siddij3/Inkjet-Printer/README.md

# Inkjet-Printer

DIY Inkjet Printer using Rep-Rap 3D Printing inspired parts and components
