siddij3/Inkjet-Printer/HP45 Printhed PCB/PCB-BOM.xlsx

Quantity | Value | Part Name | Model | Digikey Part #
4 | 0.1µF | Capacitor | C0603 | 399-6304-6-ND (https://www.digikey.ca/product-detail/en/kemet/C0603T104K5RALTU/399-6304-6-ND/2793681)
1 | 0.33µF | Capacitor | C0603 | 399-4916-6-ND (https://www.digikey.ca/product-detail/en/kemet/C0603C334K4RACTU/399-4916-6-ND/1305499)
9 |  | Spring Loaded Pin | 903 | ED90344-ND
1 |  | Voltage Regulator | L78M05CDT | 511-L78M05CDT-TR | Mouser Canada
1 |  | 5-pin Through Hole Connector | 640454-5 | A19432-ND
1 |  | Terminal Block | 282837-2 | 113320-ND
1 |  | PIC Microcontroller | PIC18F25K50T-I/ML | PIC18F25K50T-I/MLTR-ND
1 | 100 Ω | Resistor | R0805 | CR0805-FX-1000ELFCT-ND (https://www.digikey.ca/product-detail/en/bourns-inc/CR0805-FX-1000ELF/CR0805-FX-1000ELFCT-ND/3740922)
1 | 10 KΩ | Resistor | R0805 | CR0805-FX-1002ELFTR-ND (https://www.digikey.ca/product-detail/en/bourns-inc/CR0805-FX-1002ELF/CR0805-FX-1002ELFTR-ND/3593209)
8 | 5 KΩ | Resistor | R0603 | CR0603-FX-5101ELFCT-ND (https://www.digikey.ca/product-detail/en/bourns-inc/CR0603-FX-5101ELF/CR0603-FX-5101ELFCT-ND/3925320)
2 | 1KΩ | Resistor | R0603 | CR0603-FX-1001ELFCT-ND (https://www.digikey.ca/product-detail/en/bourns-inc/CR0603-FX-1001ELF/CR0603-FX-1001ELFCT-ND/3592910)
2 |  | Voltage Level Shifter | CD4504BPWE4 | CD4504BPWE4-ND
8 |  | P-Channel MOSFET | DMG1013UWQ-7 | DMG1013UW-7DICT-ND
2 | 10Ω | Resistor | R0603 | CR0603-JW-100ELFCT-ND (https://www.digikey.ca/product-detail/en/bourns-inc/CR0603-JW-100ELF/CR0603-JW-100ELFCT-ND/3925328)
