siddij3/Inkjet-Printer/Mechanical/Y Belt Holder 2.0.stl

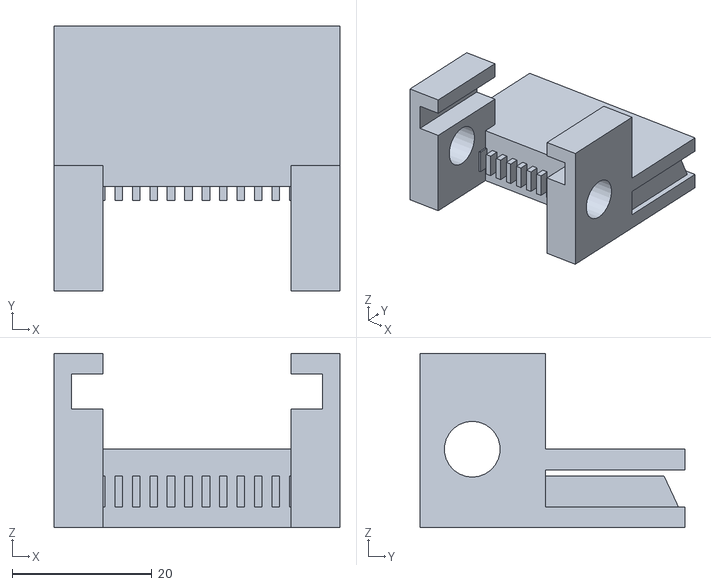
[picture p1: CAD file, 2018-04-26]
Mechanical/Y Belt Holder 2.0.stl
41.0 x 38.0 x 25.0
