siddij3/Inkjet-Printer/Mechanical/Bearing O.stl

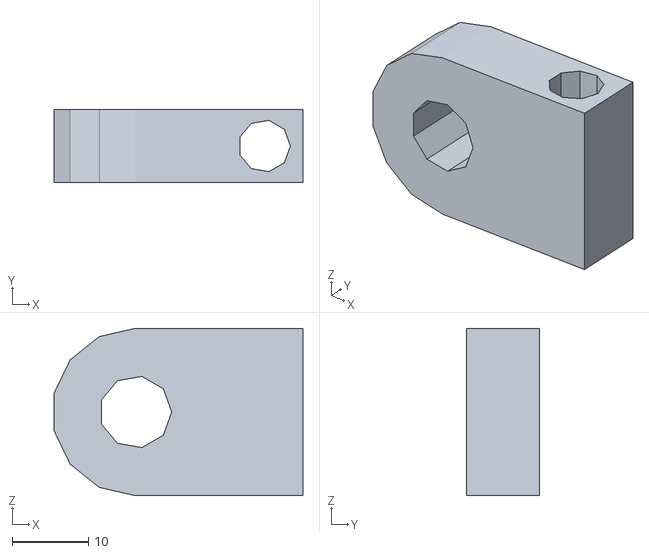
[picture p2: CAD file, 2018-04-19]
Mechanical/Bearing O.stl
32.7 x 9.60 x 22.0
