siddij3/Inkjet-Printer/Mechanical/Y- motor carrier.stl

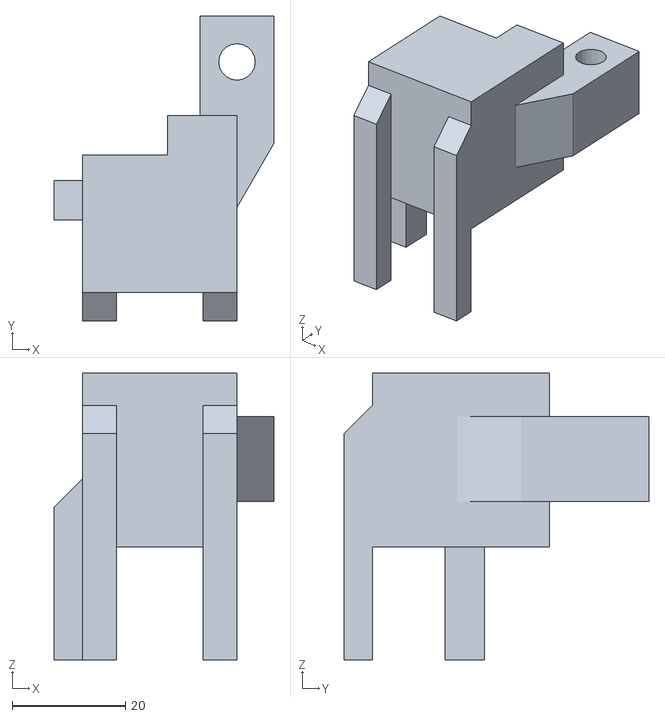
[picture p3: CAD file, 2018-04-19]
Mechanical/Y- motor carrier.stl
38.8 x 53.8 x 50.7
