siddij3/Inkjet-Printer/Mechanical/bearing C modified.stl

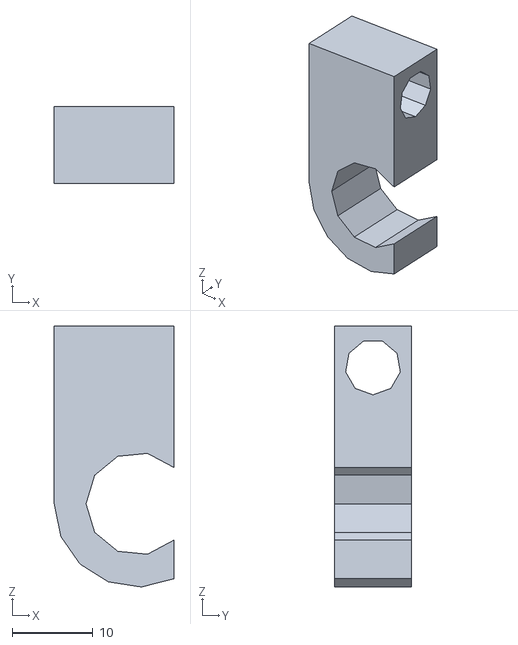
[picture p4: CAD file, 2018-04-14]
Mechanical/bearing C modified.stl
14.8 x 9.52 x 32.2
