siddij3/Inkjet-Printer/Mechanical/bearing circular.SLDPRT

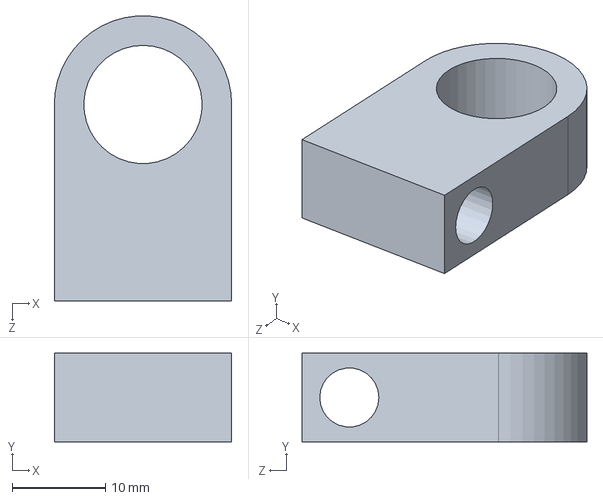
[picture p5: CAD file, 2018-04-14]
Mechanical/bearing circular.SLDPRT
19.1 x 9.53 x 30.6 mm
