siddij3/Inkjet-Printer/Mechanical/cartridge holder.STL

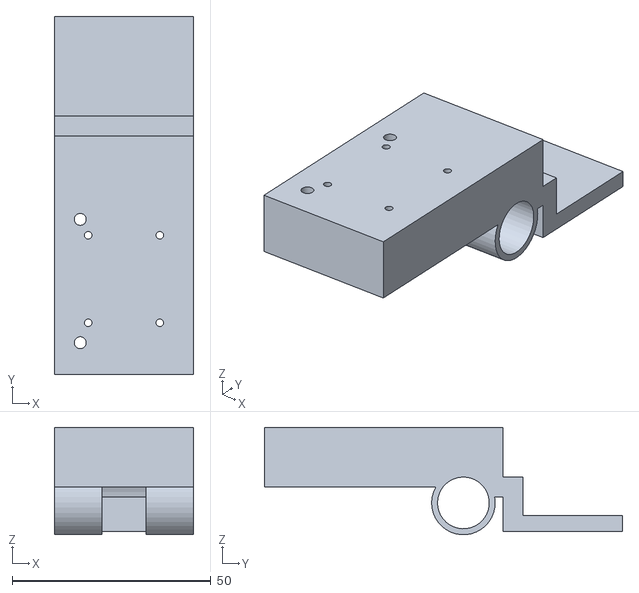
[picture p6: CAD file, 2018-04-14]
Mechanical/cartridge holder.STL
35.0 x 90.0 x 27.0
