siddij3/Inkjet-Printer/Mechanical/Xbelt Holder 5.0.stl

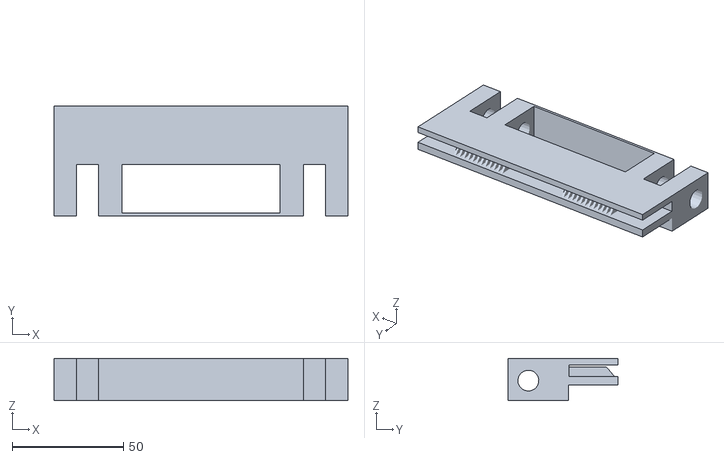
[picture p7: CAD file, 2018-04-14]
Mechanical/Xbelt Holder 5.0.stl
132.0 x 49.2 x 19.0
