siddij3/Inkjet-Printer/Mechanical/base and bar clamp.stl

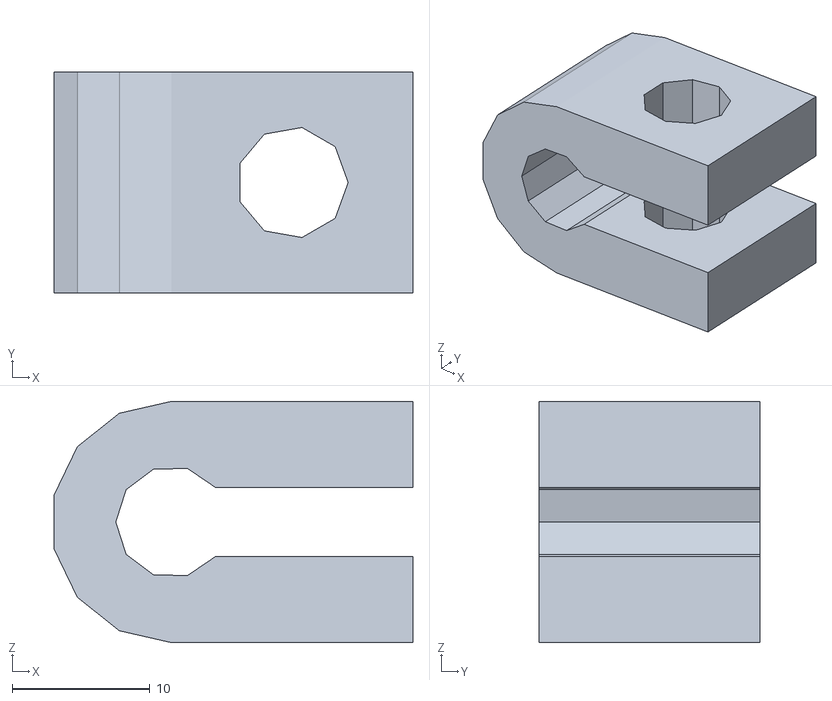
[picture p8: CAD file, 2018-04-14]
Mechanical/base and bar clamp.stl
26.0 x 16.0 x 17.5
