siddij3/Inkjet-Printer/Mechanical/y axis idler mount .SLDPRT

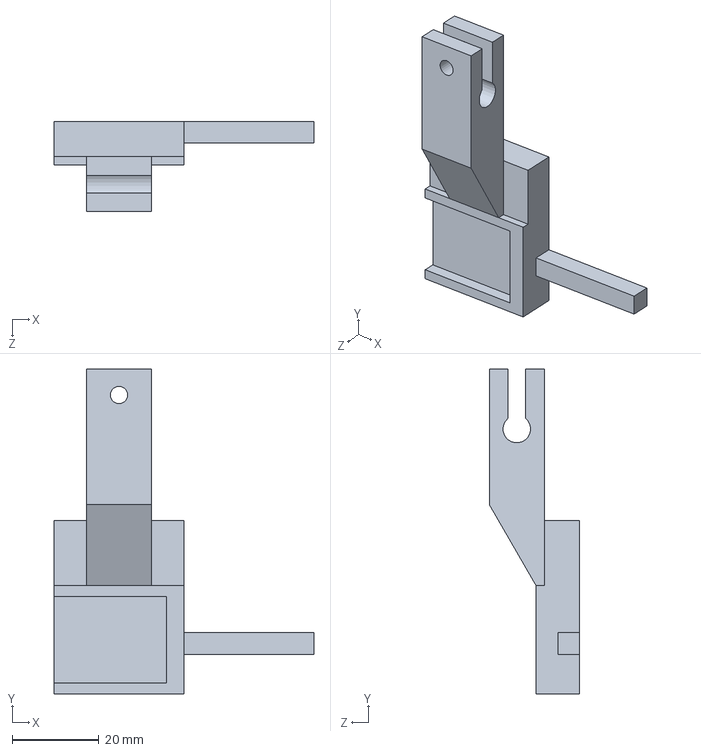
[picture p9: CAD file, 2018-04-14]
Mechanical/y axis idler mount .SLDPRT
60.0 x 75.0 x 20.9 mm
