siddij3/Inkjet-Printer/Mechanical/y-axis motor mount.SLDPRT

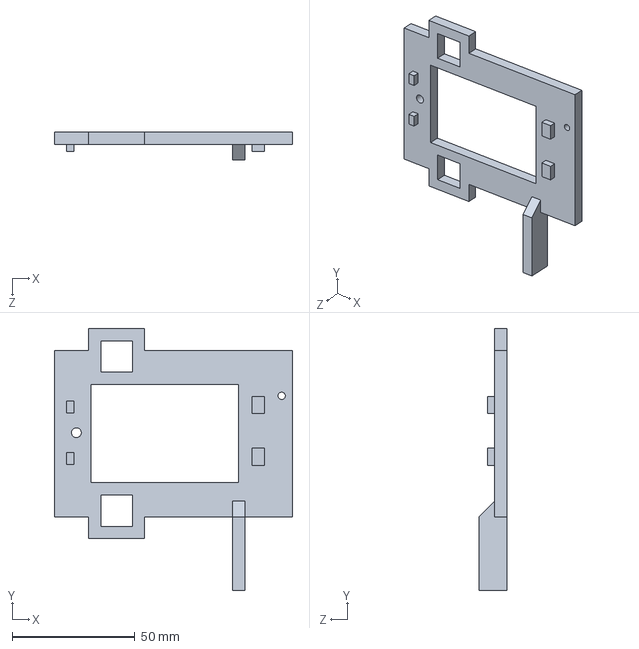
[picture p10: CAD file, 2018-04-14]
Mechanical/y-axis motor mount.SLDPRT
97.0 x 106.6 x 11.4 mm
