siddij3/Inkjet-Printer/Mechanical/y-axis motor mount modified.stl

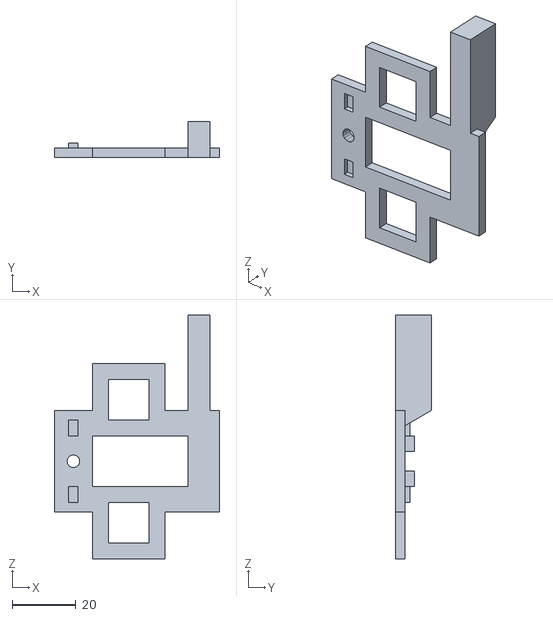
[picture p11: CAD file, 2018-04-14]
Mechanical/y-axis motor mount modified.stl
52.0 x 11.4 x 76.8
