siddij3/Inkjet-Printer/Mechanical/new_y_motor.stl

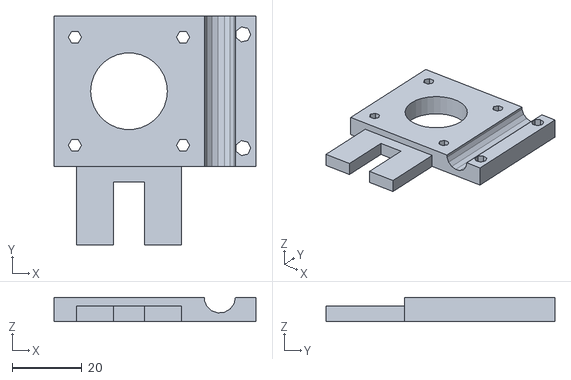
[picture p12: CAD file, 2018-04-14]
Mechanical/new_y_motor.stl
57.9 x 65.5 x 7.00
