siddij3/Inkjet-Printer/Mechanical/Rod1.SLDPRT

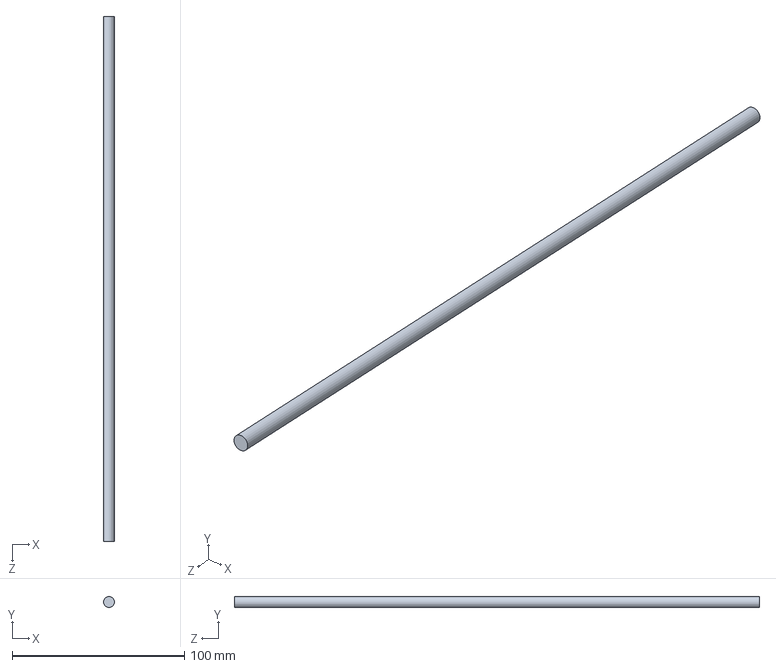
[picture p13: CAD file, 2018-04-14]
Mechanical/Rod1.SLDPRT
6.35 x 6.35 x 304.8 mm
