siddij3/Inkjet-Printer/Mechanical/Y Belt Holder.stl

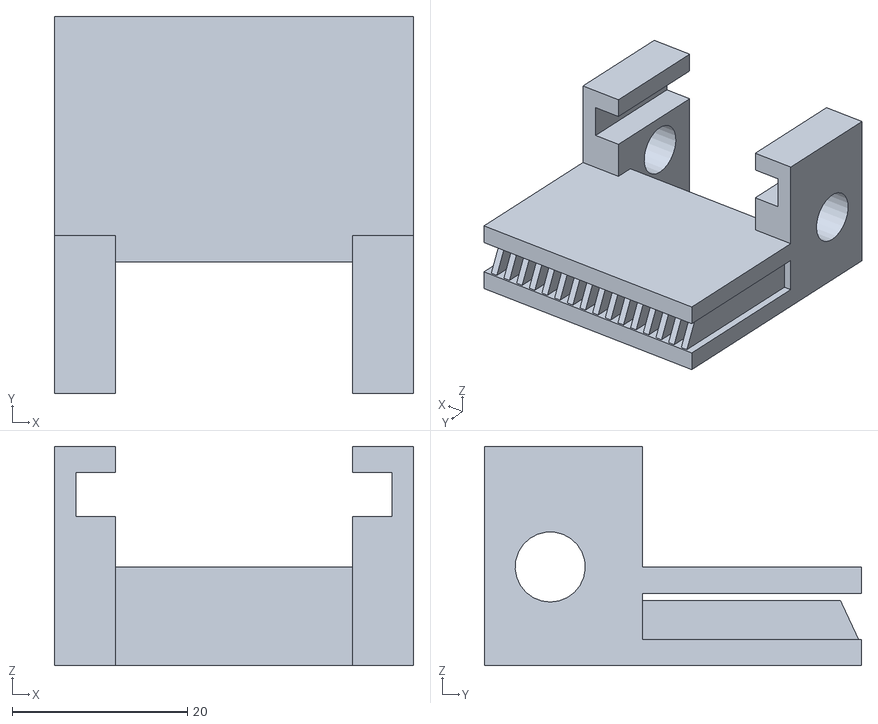
[picture p14: CAD file, 2018-04-14]
Mechanical/Y Belt Holder.stl
41.0 x 43.0 x 25.0
