siddij3/Inkjet-Printer/Mechanical/bearing C.SLDPRT

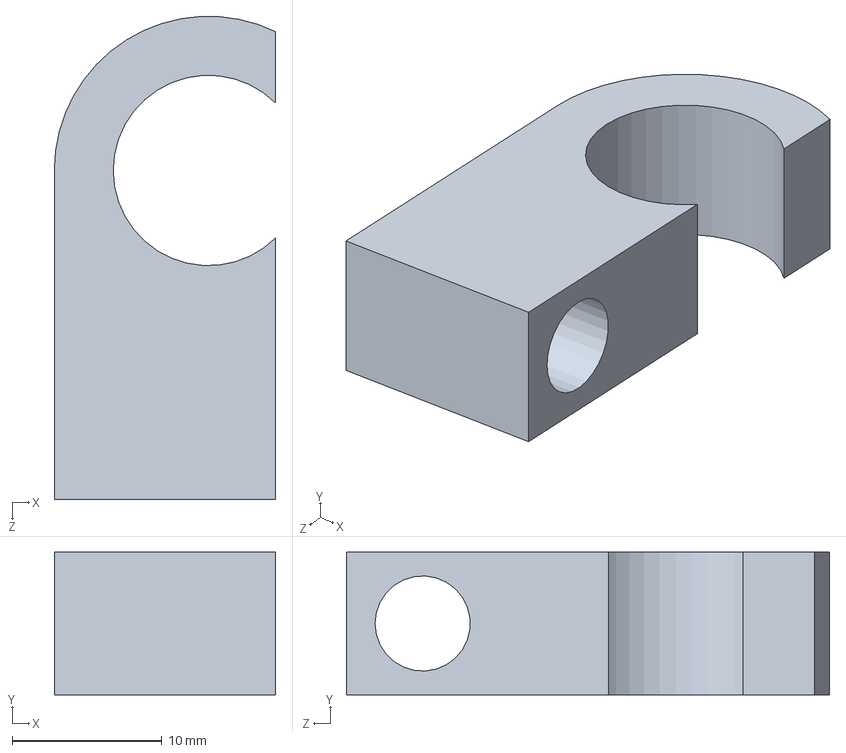
[picture p15: CAD file, 2018-04-14]
Mechanical/bearing C.SLDPRT
14.8 x 9.53 x 32.2 mm
