siddij3/Inkjet-Printer/Mechanical/HP45 Printhead Cap.stl

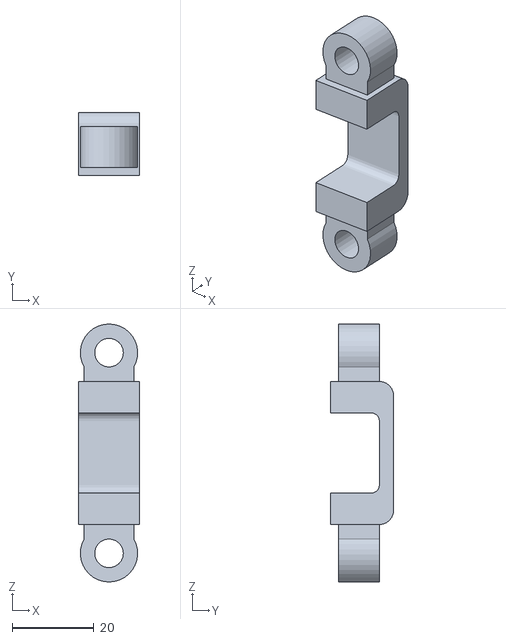
[picture p16: CAD file, 2018-04-14]
Mechanical/HP45 Printhead Cap.stl
15.0 x 15.5 x 63.0
