siddij3/Inkjet-Printer/Mechanical/y bar clamp modified.stl

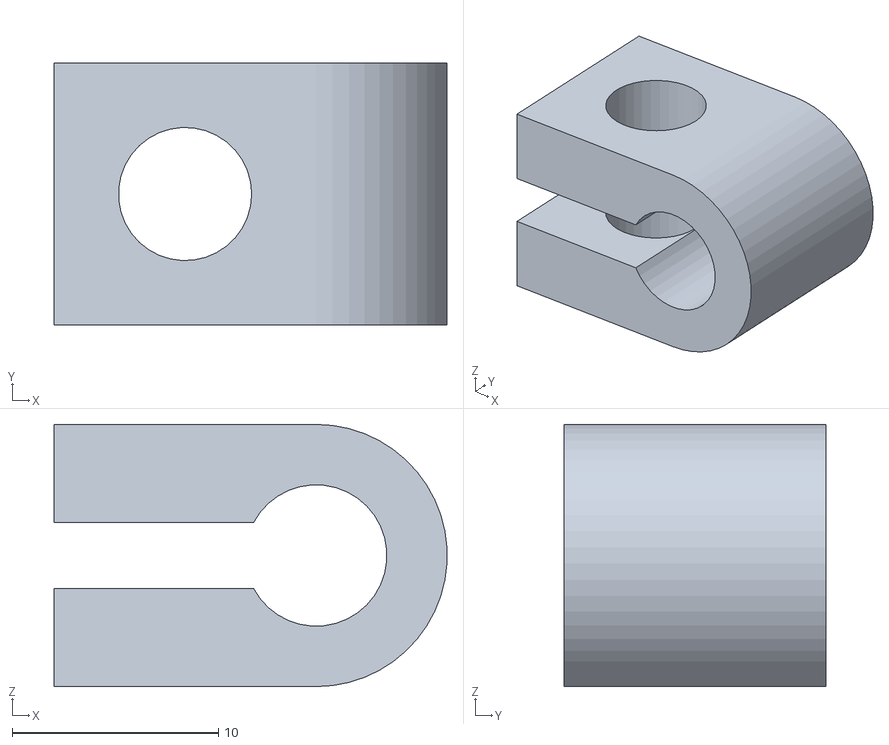
[picture p17: CAD file, 2018-04-14]
Mechanical/y bar clamp modified.stl
19.0 x 12.7 x 12.7
