siddij3/Inkjet-Printer/Mechanical/motor mount clamp1.SLDPRT

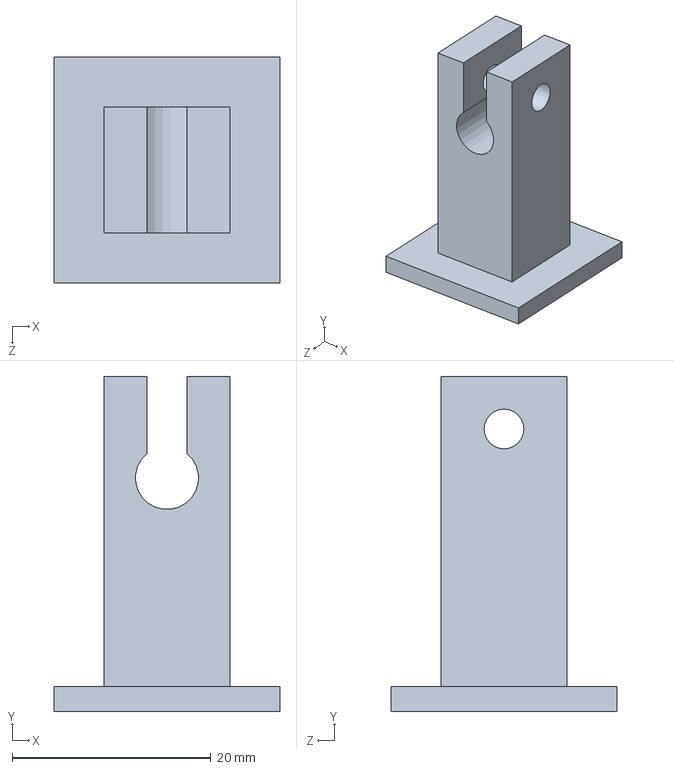
[picture p18: CAD file, 2018-04-14]
Mechanical/motor mount clamp1.SLDPRT
22.7 x 33.7 x 22.7 mm
