siddij3/Inkjet-Printer/Mechanical/Rod 2.SLDPRT

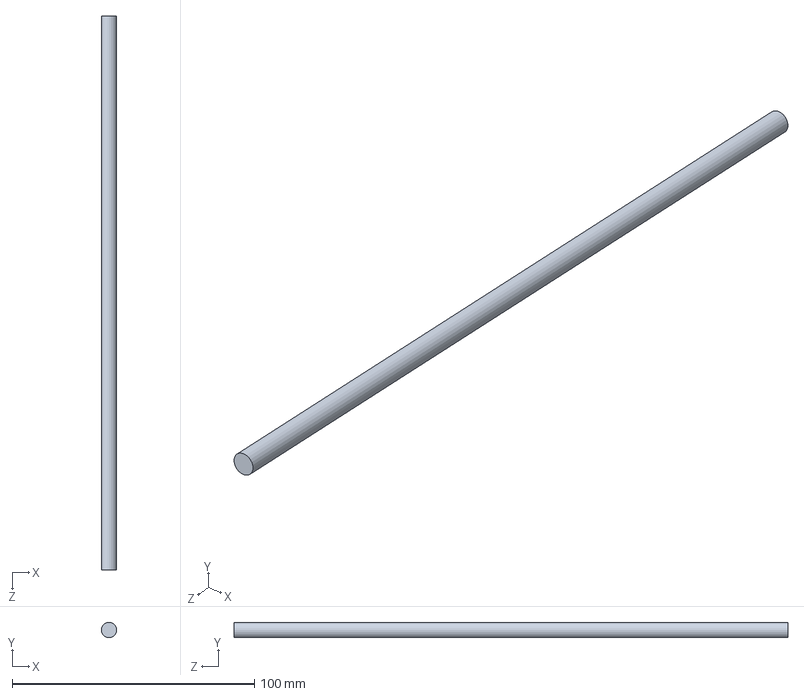
[picture p19: CAD file, 2018-04-14]
Mechanical/Rod 2.SLDPRT
6.35 x 6.35 x 228.6 mm
