siddij3/Inkjet-Printer/Mechanical/angle connector right.SLDPRT

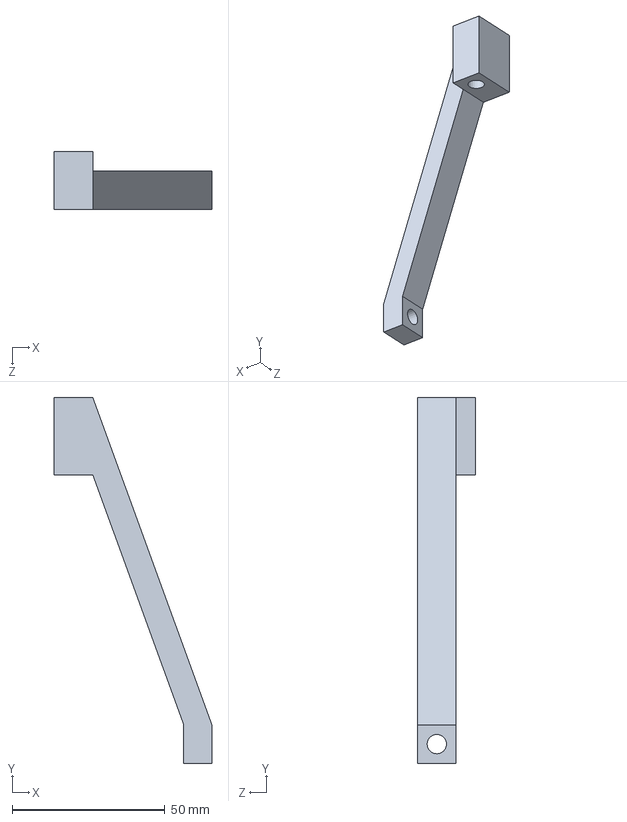
[picture p20: CAD file, 2018-04-14]
Mechanical/angle connector right.SLDPRT
51.8 x 120.0 x 19.1 mm
