siddij3/Inkjet-Printer/Mechanical/belt clamp T.SLDPRT

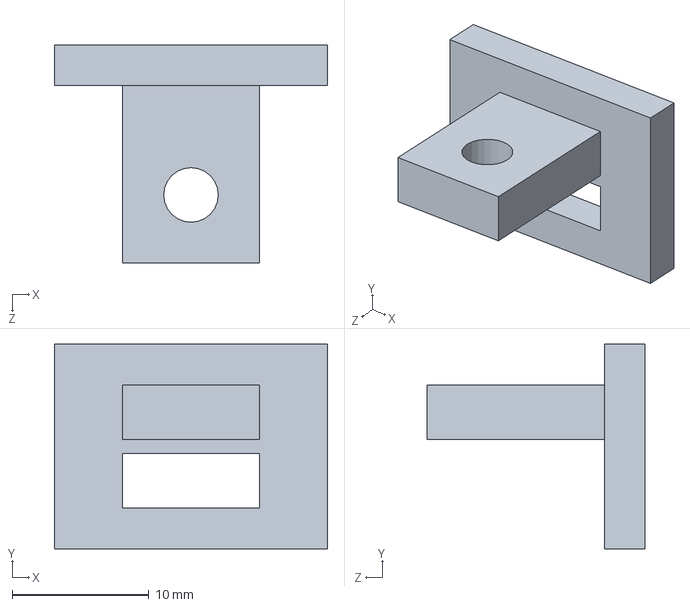
[picture p21: CAD file, 2018-04-14]
Mechanical/belt clamp T.SLDPRT
20.0 x 15.0 x 16.0 mm
