siddij3/Inkjet-Printer/Mechanical/Xbelt Holder 4.0.stl

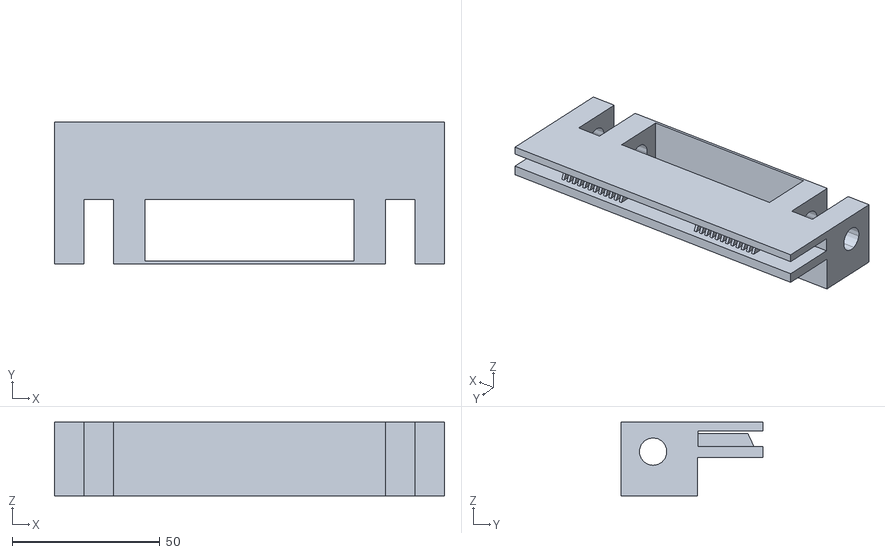
[picture p22: CAD file, 2018-04-14]
Mechanical/Xbelt Holder 4.0.stl
132.0 x 48.0 x 25.0
