siddij3/Inkjet-Printer/Mechanical/new_y_motor_clamp.stl

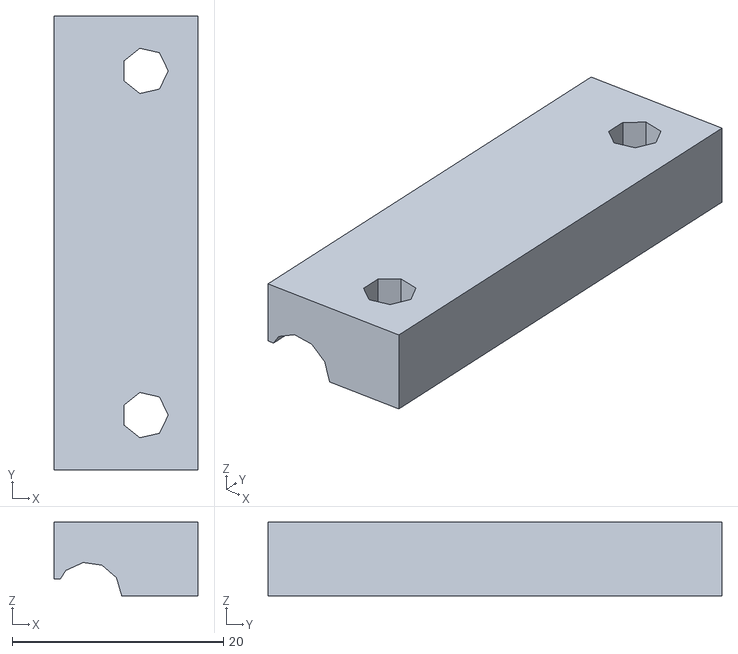
[picture p23: CAD file, 2018-04-14]
Mechanical/new_y_motor_clamp.stl
13.6 x 43.0 x 7.00
