siddij3/Inkjet-Printer/Mechanical/Xbelt Holder alternate.stl

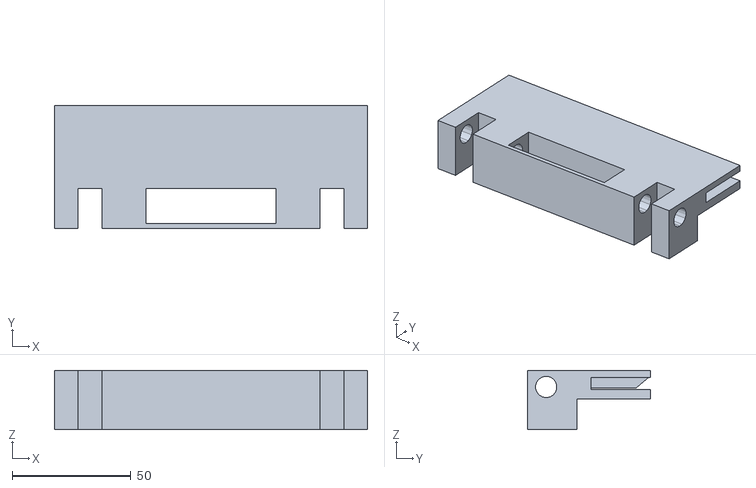
[picture p24: CAD file, 2018-04-14]
Mechanical/Xbelt Holder alternate.stl
132.0 x 51.8 x 25.0
