siddij3/Inkjet-Printer/Mechanical/Xbelt Holder - horizontal.stl

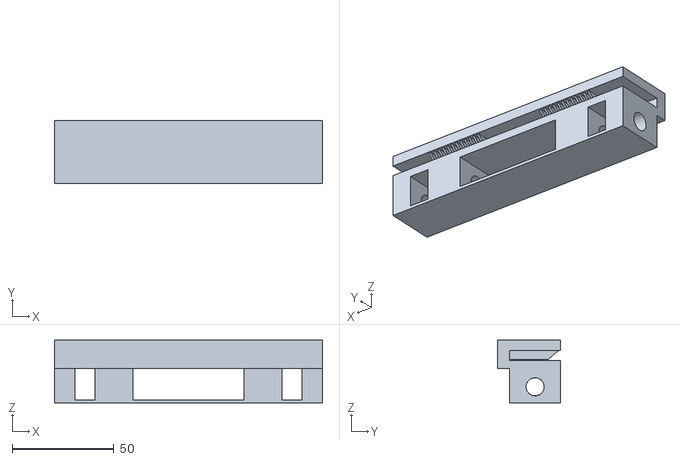
[picture p25: CAD file, 2018-04-14]
Mechanical/Xbelt Holder - horizontal.stl
132.0 x 31.0 x 30.8
