siddij3/Inkjet-Printer/Mechanical/Rod Vertical.SLDPRT

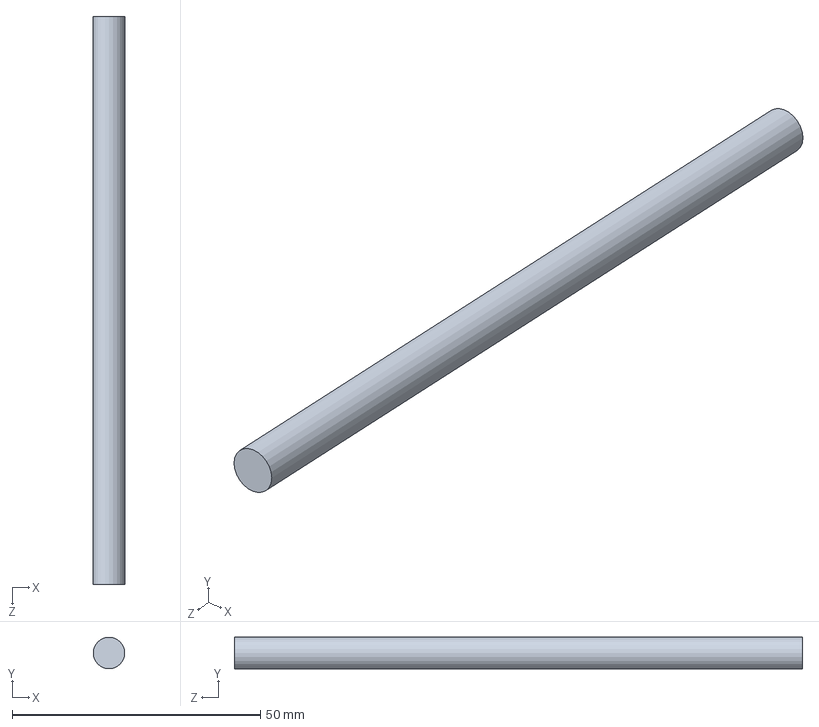
[picture p26: CAD file, 2018-04-14]
Mechanical/Rod Vertical.SLDPRT
6.35 x 6.35 x 114.3 mm
