siddij3/Inkjet-Printer/Mechanical/y axis rod.SLDPRT

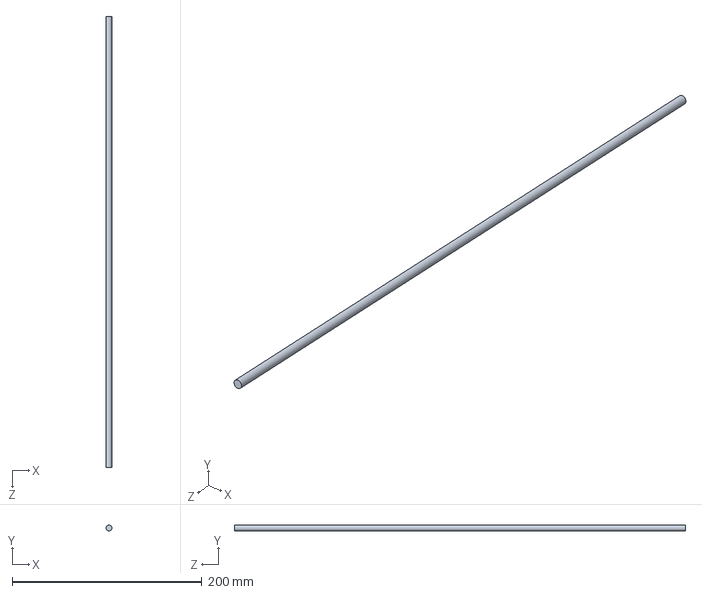
[picture p27: CAD file, 2018-04-14]
Mechanical/y axis rod.SLDPRT
6.35 x 6.35 x 475.0 mm
