siddij3/Inkjet-Printer/Mechanical/x axis rail(516).SLDPRT

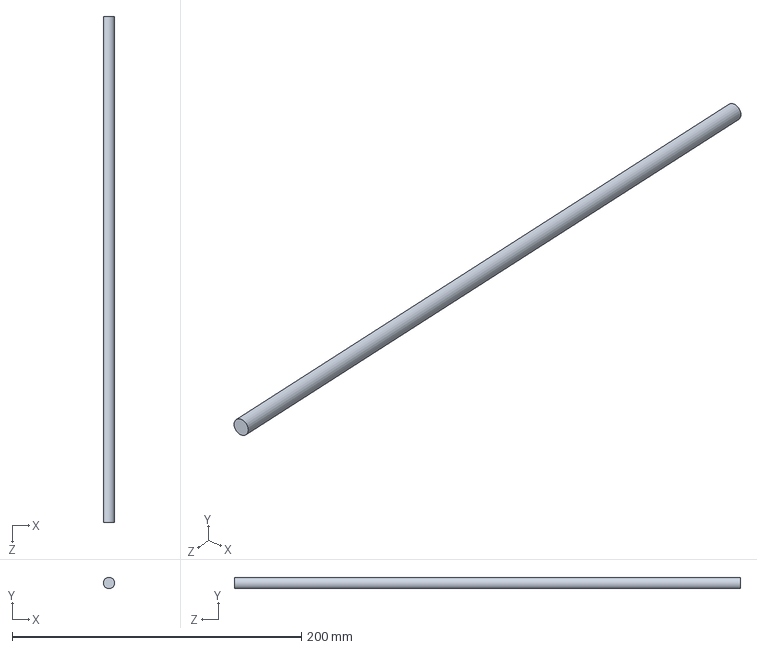
[picture p28: CAD file, 2018-04-14]
Mechanical/x axis rail(516).SLDPRT
7.94 x 7.94 x 350.0 mm
