siddij3/Inkjet-Printer/Mechanical/belt clamp bar.SLDPRT

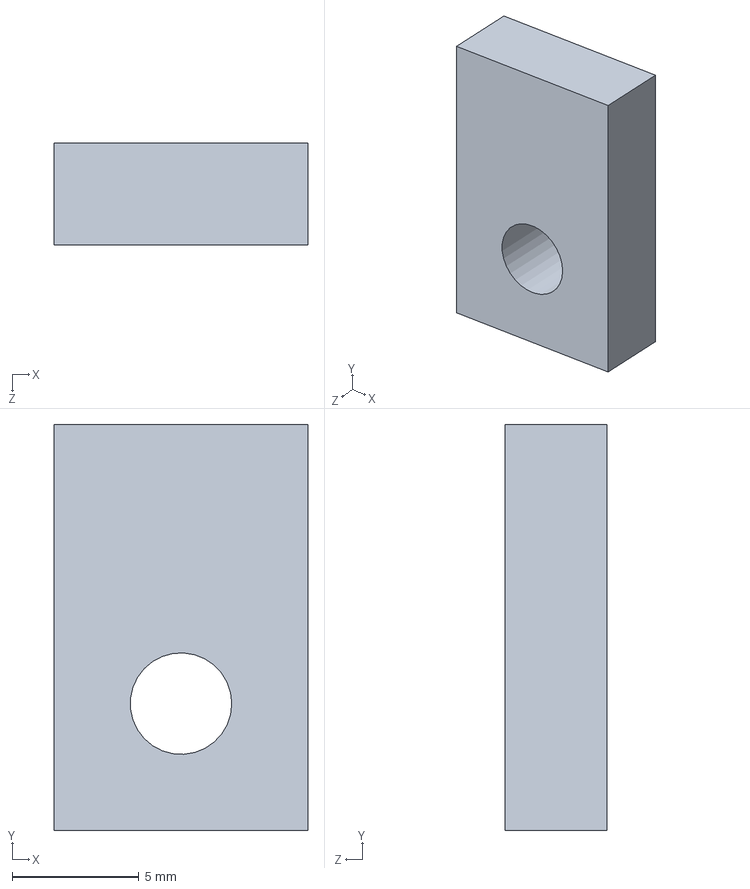
[picture p29: CAD file, 2018-04-14]
Mechanical/belt clamp bar.SLDPRT
10.0 x 16.0 x 4.00 mm
