siddij3/Inkjet-Printer/Mechanical/Xbelt Holder 3.0.stl

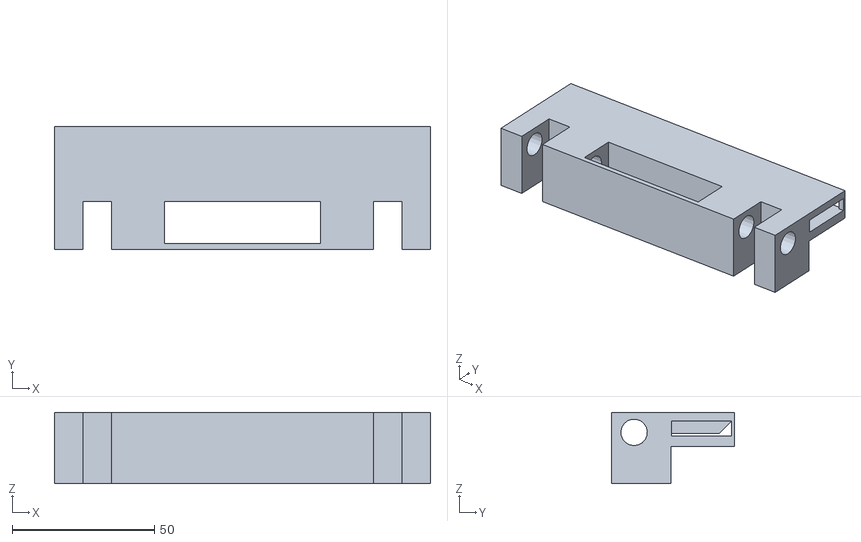
[picture p30: CAD file, 2018-04-14]
Mechanical/Xbelt Holder 3.0.stl
132.0 x 43.0 x 25.0
