siddij3/Inkjet-Printer/Mechanical/HP45 Printhead Holder.stl

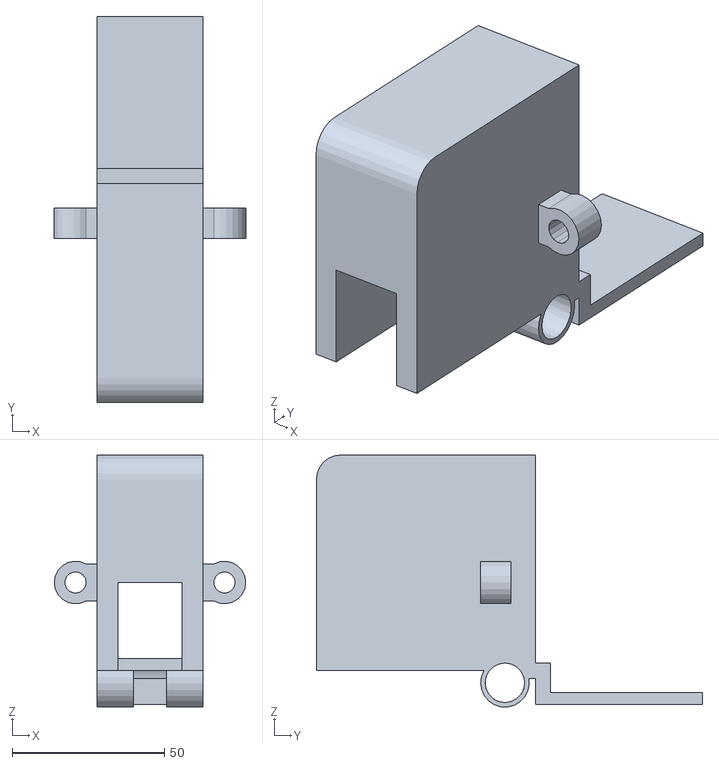
[picture p31: CAD file, 2018-04-14]
Mechanical/HP45 Printhead Holder.stl
63.0 x 127.0 x 82.9
