siddij3/Inkjet-Printer/Mechanical/x axis slider.SLDPRT

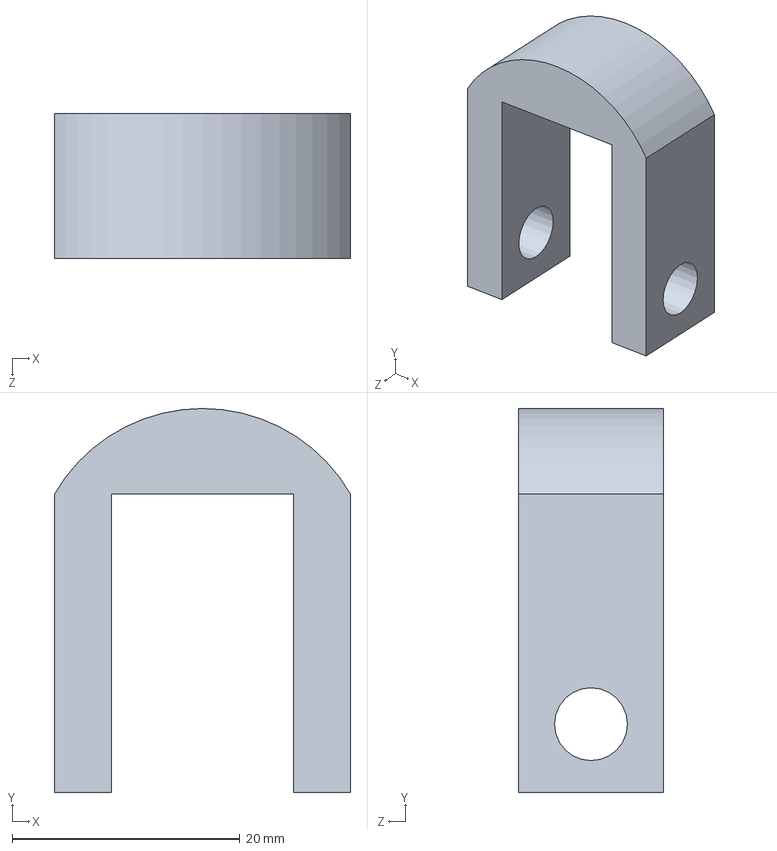
[picture p32: CAD file, 2018-04-14]
Mechanical/x axis slider.SLDPRT
26.0 x 33.7 x 12.7 mm
