siddij3/Inkjet-Printer/Mechanical/cartridge holder modified.stl

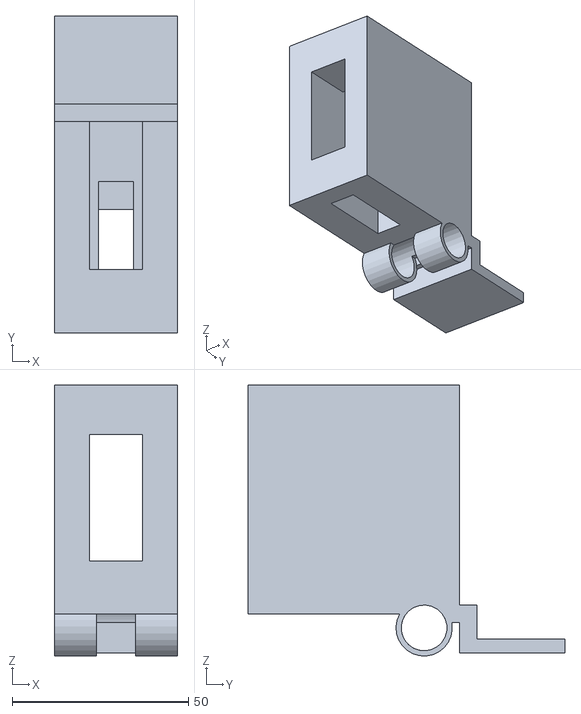
[picture p33: CAD file, 2018-04-14]
Mechanical/cartridge holder modified.stl
35.0 x 90.0 x 77.0
