siddij3/Inkjet-Printer/Mechanical/motor mount rod.SLDPRT

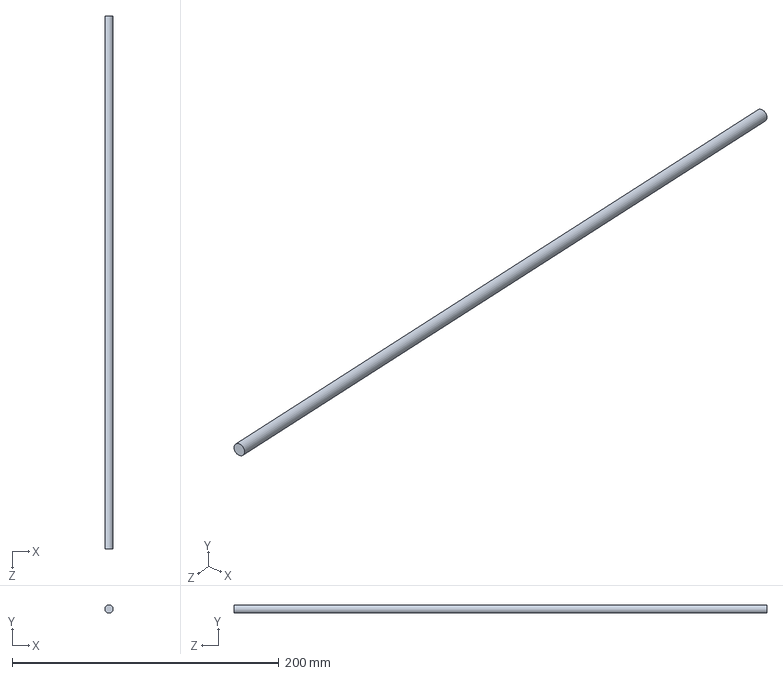
[picture p34: CAD file, 2018-04-14]
Mechanical/motor mount rod.SLDPRT
6.35 x 6.35 x 400.0 mm
