siddij3/Inkjet-Printer/Mechanical/y bar clamp.SLDPRT

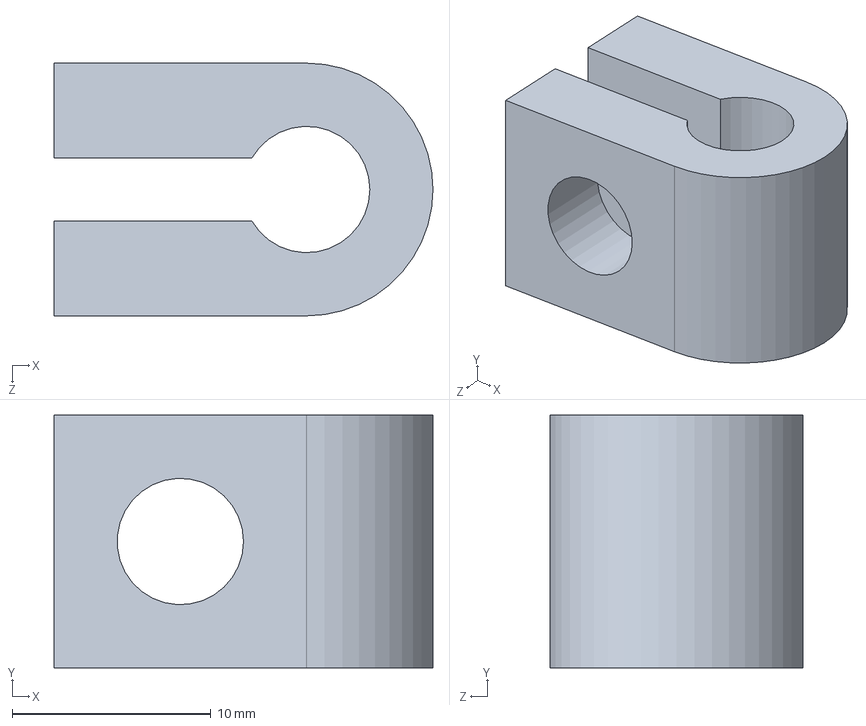
[picture p35: CAD file, 2018-04-14]
Mechanical/y bar clamp.SLDPRT
19.0 x 12.7 x 12.7 mm
