siddij3/Inkjet-Printer/(list of files, cad)

Other CAD files:
PIC Code/PIC18F25K50.X/dist/default/production/PIC18F25K50.X.production.obj
Mechanical/Xbelt Holder.stl
Mechanical/motor mount clamp.STL
Mechanical/Xbelt Holder 2.0.stl
Mechanical/cartridge holder1.SLDPRT
Mechanical/angle connector left.SLDPRT
Mechanical/Xbelt Holder 3.1.stl
Mechanical/Bearing O.ipt
Mechanical/Carriage Assembly.iam
Mechanical/HP45 Printhead Cap.ipt
Mechanical/HP45 Printhead Holder.ipt
Mechanical/HP45.ipt
Mechanical/OldVersions/Bearing O.0002.ipt
Mechanical/OldVersions/Printhead.0001.iam
Mechanical/OldVersions/Y- motor carrier.0027.ipt
Mechanical/Printhead.iam
Mechanical/Rod 2.ipt
Mechanical/Rod 2.stl
Mechanical/Rod Vertical.ipt
Mechanical/Rod Vertical.stl
Mechanical/Rod1.ipt
Mechanical/Rod1.stl
Mechanical/XY Carriage Assembly.iam
Mechanical/Xbelt Holder.ipt
Mechanical/Y Belt Holder.ipt
Mechanical/Y- motor carrier.ipt
Mechanical/angle connector left.STL
Mechanical/angle connector left.ipt
Mechanical/angle connector right.STL
Mechanical/angle connector right.ipt
Mechanical/base and bar clamp.ipt
Mechanical/bearing C modified.ipt
Mechanical/bearing C.STL
Mechanical/bearing C.ipt
Mechanical/bearing circular.STL
Mechanical/belt clamp T.stl
Mechanical/belt clamp bar.stl
Mechanical/cartridge holder modified.ipt
Mechanical/cartridge holder1.ipt
Mechanical/motor mount clamp1.ipt
Mechanical/motor mount rod.ipt
Mechanical/x axis rail(516).ipt
Mechanical/x axis rail(516).stl
Mechanical/x axis slider.STL
Mechanical/y axis idler mount .ipt
Mechanical/y axis idler mount.STL
Mechanical/y axis rod.ipt
Mechanical/y bar clamp.STL
Mechanical/y bar clamp.ipt
Mechanical/y-axis motor mount modified.ipt
Mechanical/y-axis motor mount.STL
Mechanical/y-axis motor mount.ipt
