siddij3/Inkjet-Printer/HP45 Printhed PCB/HP45 PCB.pdf

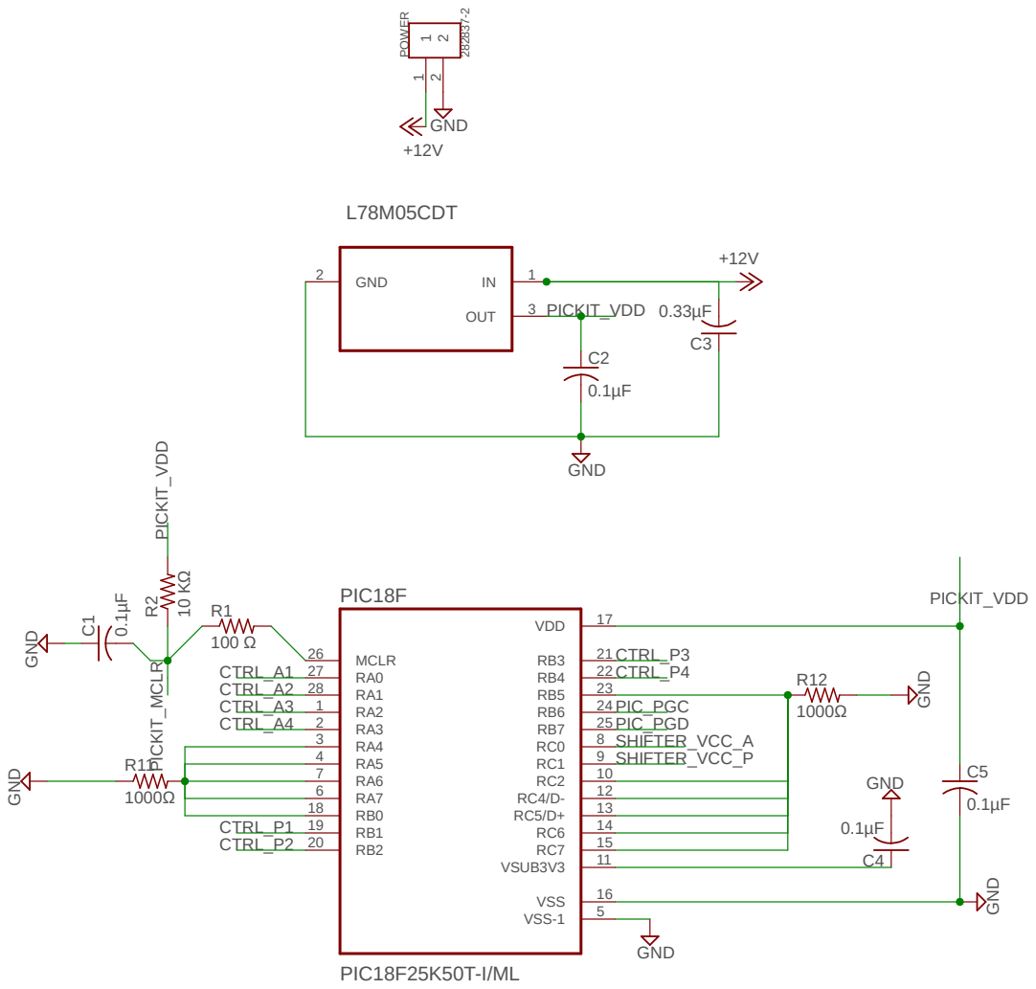
[picture p36: figure]
PIC18F25K50T-I/ML; GND GND; GND; 1000Ω GND; MCLR 26; VDD; 15 VSUB3V3; 11 VSS; 16 VSS-1; PIC18F; POWER; L78M05CDT; 1 OUT; 3 GND 2 PICKIT_MCLR; CTRL_A1; CTRL_A2 CTRL_A3 CTRL_A4; SHIFTER_VCC_P; SHIFTER_VCC_A; CTRL_P1 CTRL_P2; CTRL_P3 CTRL_P4; PIC_PGC PIC_PGD; PICKIT_VDD PICKIT_VDD; PICKIT_VDD

2018-04-23 10:57 AM C:\Users\junai\Documents\GitHub\Inkjet-Printer\HP45 Printhed PCB\schematic.sch (Sheet: 1/4)

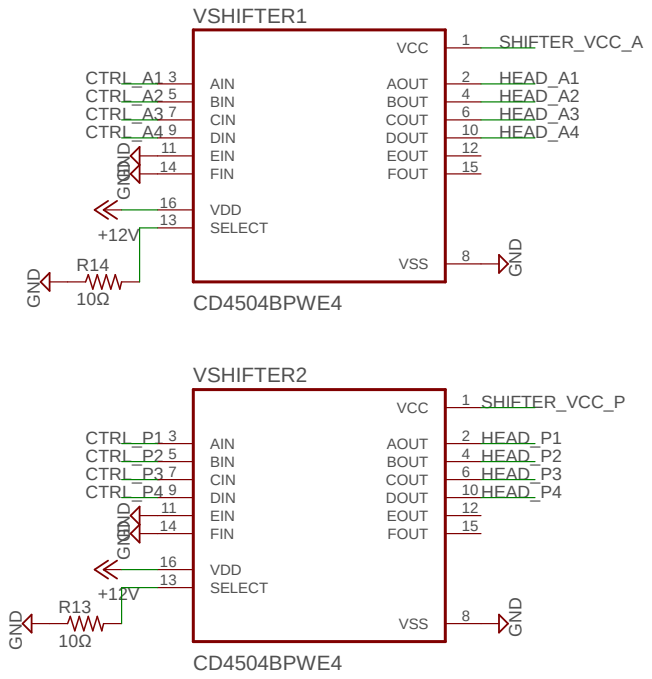
[picture p37: figure]
CD4504BPWE4; GND+12V; GND+12VGND GND; 10Ω GND; AIN 3; BIN 5; CIN 7; DIN 9; EIN 11; FIN 14; VDD 16; SELECT 13; VCC; 1 AOUT; 2 BOUT; 4 COUT; 6 DOUT; 10 EOUT; 12 FOUT; 15 VSS; 8 VSHIFTER1; 8 VSHIFTER2; SHIFTER_VCC_A; CTRL_A1 CTRL_A2 CTRL_A3 CTRL_A4; HEAD_A1 HEAD_A2 HEAD_A3 HEAD_A4; CTRL_P1 CTRL_P2 CTRL_P3 CTRL_P4; HEAD_P1 HEAD_P2 HEAD_P3 HEAD_P4; SHIFTER_VCC_P

2018-04-23 10:57 AM C:\Users\junai\Documents\GitHub\Inkjet-Printer\HP45 Printhed PCB\schematic.sch (Sheet: 2/4)

DMG1013UWQ-7 | GND GND GND GND GND GND ⁺¹²V +12V +12V +12V +12V +12V +12V +12V | GND GND
GATE | 1 SOURCE | 2 DRAIN | 3 MOSFET1 GATE | 1 SOURCE | 2 DRAIN | 3 MOSFET3 GATE | 1 SOURCE | 2 DRAIN | 3 MOSFET5 GATE | 1 SOURCE | 2 DRAIN | 3 MOSFET7

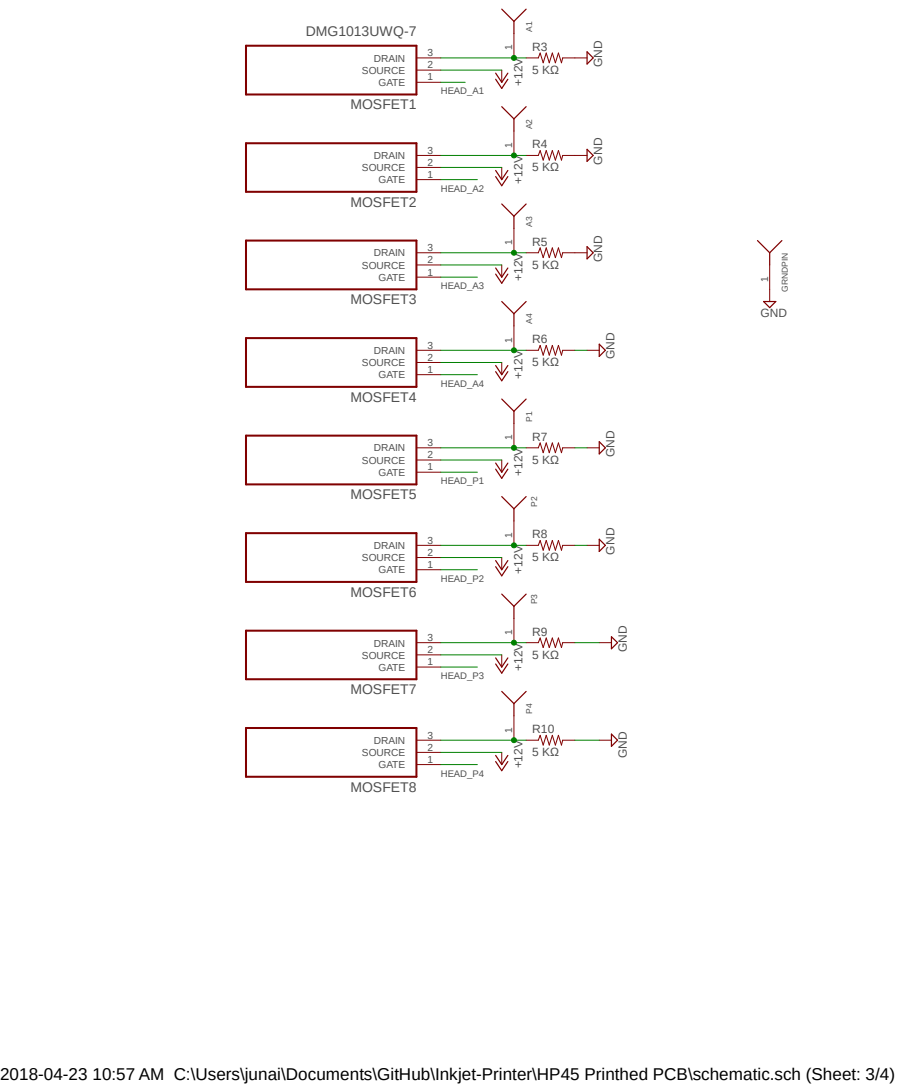
[picture p38: page 3]

2018-04-23 10:57 AM C:\Users\junai\Documents\GitHub\Inkjet-Printer\HP45 Printhed PCB\schematic.sch (Sheet: 3/4)

2018-04-23 10:58 AM C:\Users\junai\Documents\GitHub\Inkjet-Printer\HP45 Printhed PCB\schematic.sch (Sheet: 4/4)

# 640454-5 GND

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
# 5 PROGRAMMER

### PICKIT_MCLR PICKIT_VDD

### PIC_PGD PIC_PGC
