siddij3/Inkjet-Printer/HP45 Printhed PCB/schematic.brd

## EAGLE design HP45 Printhed PCB/schematic.brd (2018-04-23)

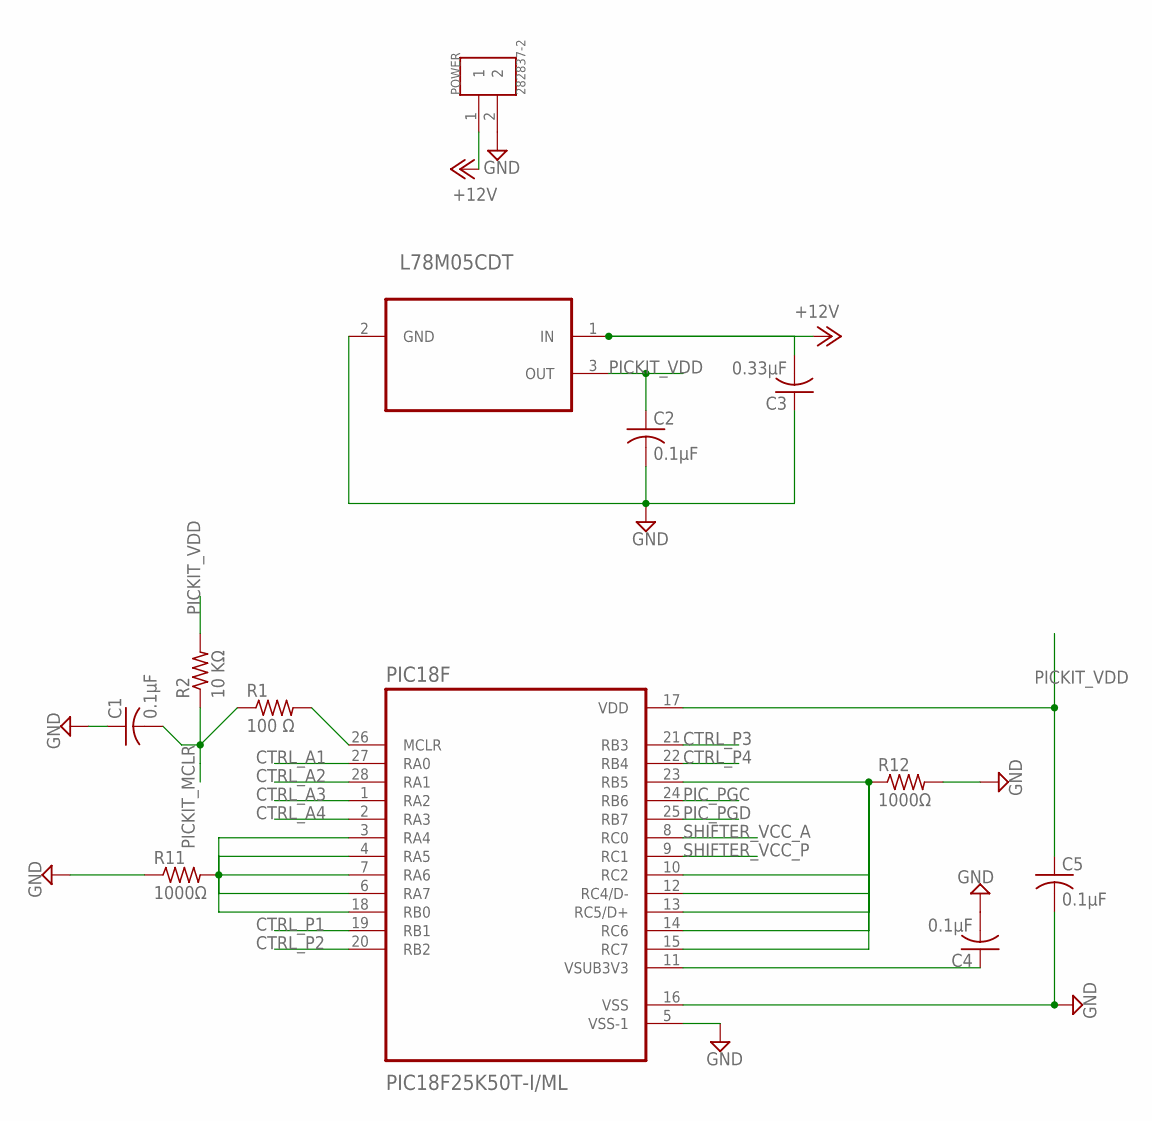
[picture p39: schematic schematic.sch, sheet 1]

Parts:
C1, C2, C4, C5: 0.1µF; C0603; MPN B32529C0104J000
C3: 0.33µF; C0603
L78M05CDT: L78M05CDT; TO225P972X240-3N
PIC18F: PIC18F25K50T-I/ML; QFN65P600X600X100-29N
POWER: 282837-2; TE_282837-2
R1: 100 Ω; R0805
R2: 10 KΩ; R0805
R11, R12: 1000Ω; R0603

Connections:
+12V: C3.2, L78M05CDT.1 (IN), POWER.1; also elsewhere on the board
CTRL_A1: PIC18F.27 (RA0); also elsewhere on the board
CTRL_A2: PIC18F.28 (RA1); also elsewhere on the board
CTRL_A3: PIC18F.1 (RA2); also elsewhere on the board
CTRL_A4: PIC18F.2 (RA3); also elsewhere on the board
CTRL_P1: PIC18F.19 (RB1); also elsewhere on the board
CTRL_P2: PIC18F.20 (RB2); also elsewhere on the board
CTRL_P3: PIC18F.21 (RB3); also elsewhere on the board
CTRL_P4: PIC18F.22 (RB4); also elsewhere on the board
GND: C1.1, C2.2, C3.1, C4.2, C5.2, L78M05CDT.2 (GND), PIC18F.5 (VSS-1), PIC18F.16 (VSS), POWER.2, R11.1, R12.2; also elsewhere on the board
unnamed: C4.1, PIC18F.11 (VSUB3V3)
unnamed: PIC18F.3 (RA4), PIC18F.4 (RA5), PIC18F.6 (RA7), PIC18F.7 (RA6), PIC18F.18 (RB0), R11.2
unnamed: PIC18F.26 (MCLR), R1.2
unnamed: PIC18F.10 (RC2), PIC18F.12 (RC4/D-), PIC18F.13 (RC5/D+), PIC18F.14 (RC6), PIC18F.15 (RC7), PIC18F.23 (RB5), R12.1
PICKIT_MCLR: C1.2, R1.1, R2.1; also elsewhere on the board
PICKIT_VDD: C2.1, C5.1, L78M05CDT.3 (OUT), PIC18F.17 (VDD), R2.2; also elsewhere on the board
PIC_PGC: PIC18F.24 (RB6); also elsewhere on the board
PIC_PGD: PIC18F.25 (RB7); also elsewhere on the board
SHIFTER_VCC_A: PIC18F.8 (RC0); also elsewhere on the board
SHIFTER_VCC_P: PIC18F.9 (RC1); also elsewhere on the board

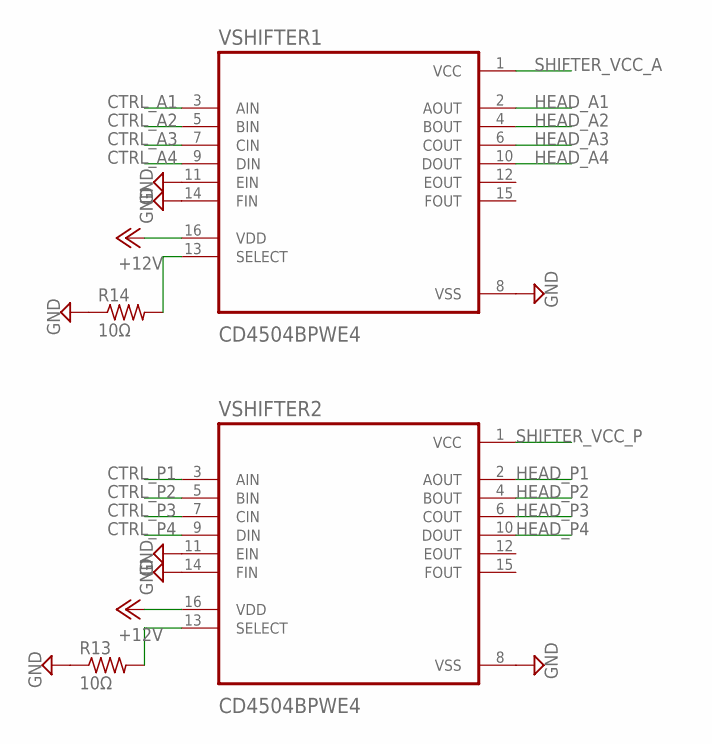
[picture p40: schematic schematic.sch, sheet 2]

Parts:
R13, R14: 10Ω; R0603
VSHIFTER1, VSHIFTER2: CD4504BPWE4; SOP65P640X120-16N

Connections:
+12V: VSHIFTER1.16 (VDD), VSHIFTER2.16 (VDD); also elsewhere on the board
CTRL_A1: VSHIFTER1.3 (AIN); also elsewhere on the board
CTRL_A2: VSHIFTER1.5 (BIN); also elsewhere on the board
CTRL_A3: VSHIFTER1.7 (CIN); also elsewhere on the board
CTRL_A4: VSHIFTER1.9 (DIN); also elsewhere on the board
CTRL_P1: VSHIFTER2.3 (AIN); also elsewhere on the board
CTRL_P2: VSHIFTER2.5 (BIN); also elsewhere on the board
CTRL_P3: VSHIFTER2.7 (CIN); also elsewhere on the board
CTRL_P4: VSHIFTER2.9 (DIN); also elsewhere on the board
GND: R13.1, R14.1, VSHIFTER1.8 (VSS), VSHIFTER1.11 (EIN), VSHIFTER1.14 (FIN), VSHIFTER2.8 (VSS), VSHIFTER2.11 (EIN), VSHIFTER2.14 (FIN); also elsewhere on the board
HEAD_A1: VSHIFTER1.2 (AOUT); also elsewhere on the board
HEAD_A2: VSHIFTER1.4 (BOUT); also elsewhere on the board
HEAD_A3: VSHIFTER1.6 (COUT); also elsewhere on the board
HEAD_A4: VSHIFTER1.10 (DOUT); also elsewhere on the board
HEAD_P1: VSHIFTER2.2 (AOUT); also elsewhere on the board
HEAD_P2: VSHIFTER2.4 (BOUT); also elsewhere on the board
HEAD_P3: VSHIFTER2.6 (COUT); also elsewhere on the board
HEAD_P4: VSHIFTER2.10 (DOUT); also elsewhere on the board
unnamed: R14.2, VSHIFTER1.13 (SELECT)
unnamed: R13.2, VSHIFTER2.13 (SELECT)
SHIFTER_VCC_A: VSHIFTER1.1 (VCC); also elsewhere on the board
SHIFTER_VCC_P: VSHIFTER2.1 (VCC); also elsewhere on the board

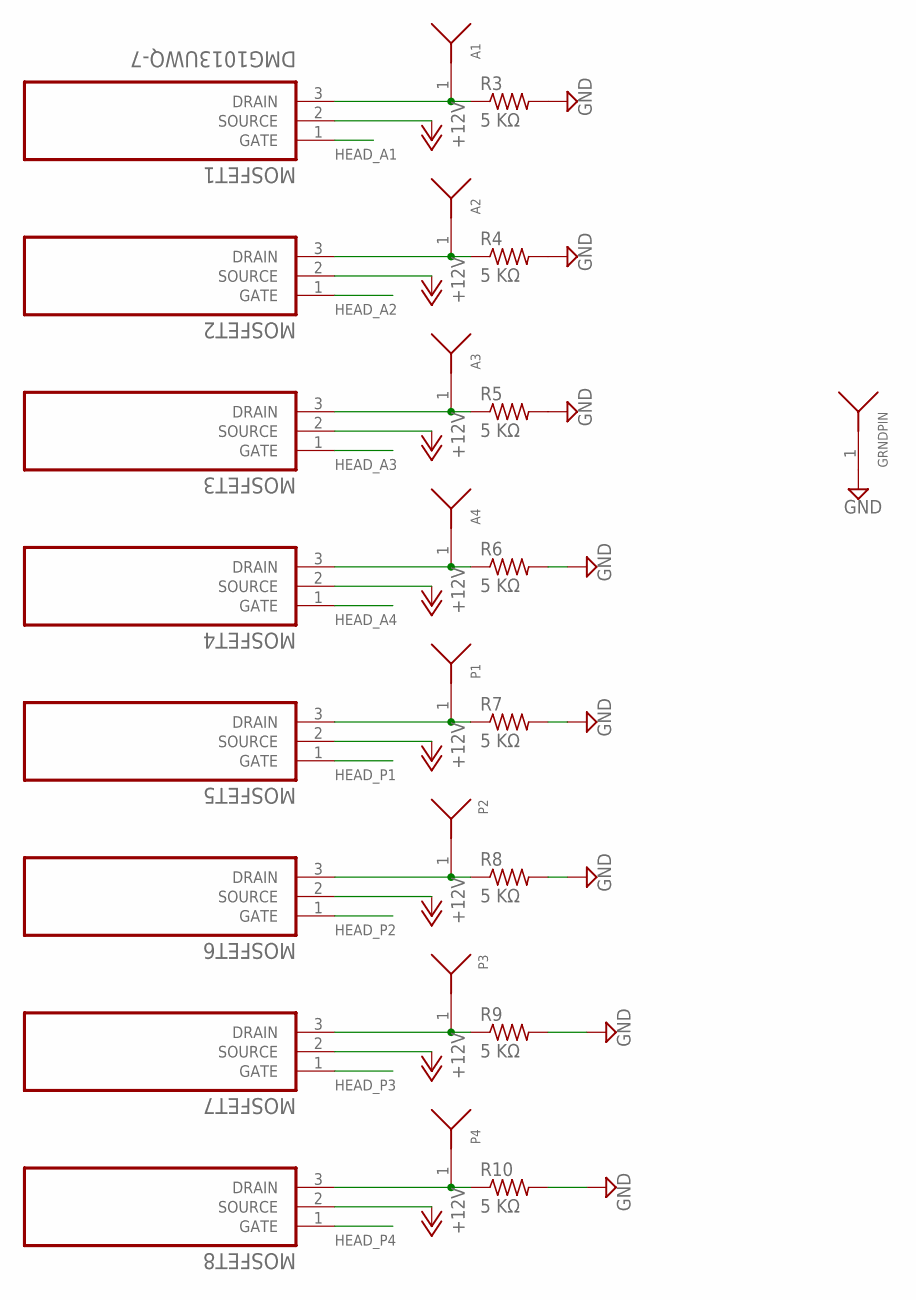
[picture p41: schematic schematic.sch, sheet 3]

Parts:
A1, A2, A3, A4: 0930
GRNDPIN: 0930
MOSFET1, MOSFET2, MOSFET3, MOSFET4, MOSFET5, MOSFET6, MOSFET7, MOSFET8: DMG1013UWQ-7; SOT65P210X110-3N
P1, P2, P3, P4: 0930
R3, R4, R5, R6, R7, R8, R9, R10: 5 KΩ; R0603

Connections:
+12V: MOSFET1.2 (SOURCE), MOSFET2.2 (SOURCE), MOSFET3.2 (SOURCE), MOSFET4.2 (SOURCE), MOSFET5.2 (SOURCE), MOSFET6.2 (SOURCE), MOSFET7.2 (SOURCE), MOSFET8.2 (SOURCE); also elsewhere on the board
GND: GRNDPIN.1, R3.2, R4.2, R5.2, R6.2, R7.2, R8.2, R9.2, R10.2; also elsewhere on the board
HEAD_A1: MOSFET1.1 (GATE); also elsewhere on the board
HEAD_A2: MOSFET2.1 (GATE); also elsewhere on the board
HEAD_A3: MOSFET3.1 (GATE); also elsewhere on the board
HEAD_A4: MOSFET4.1 (GATE); also elsewhere on the board
HEAD_P1: MOSFET5.1 (GATE); also elsewhere on the board
HEAD_P2: MOSFET6.1 (GATE); also elsewhere on the board
HEAD_P3: MOSFET7.1 (GATE); also elsewhere on the board
HEAD_P4: MOSFET8.1 (GATE); also elsewhere on the board
unnamed: A1.1, MOSFET1.3 (DRAIN), R3.1
unnamed: A2.1, MOSFET2.3 (DRAIN), R4.1
unnamed: A3.1, MOSFET3.3 (DRAIN), R5.1
unnamed: A4.1, MOSFET4.3 (DRAIN), R6.1
unnamed: MOSFET5.3 (DRAIN), P1.1, R7.1
unnamed: MOSFET6.3 (DRAIN), P2.1, R8.1
unnamed: MOSFET7.3 (DRAIN), P3.1, R9.1
unnamed: MOSFET8.3 (DRAIN), P4.1, R10.1

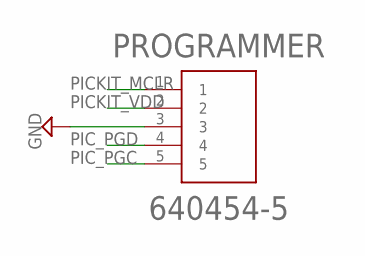
[picture p42: schematic schematic.sch, sheet 4]

Parts:
PROGRAMMER: 640454-5; TE_640454-5

Connections:
GND: PROGRAMMER.3; also elsewhere on the board
PICKIT_MCLR: PROGRAMMER.1; also elsewhere on the board
PICKIT_VDD: PROGRAMMER.2; also elsewhere on the board
PIC_PGC: PROGRAMMER.5; also elsewhere on the board
PIC_PGD: PROGRAMMER.4; also elsewhere on the board

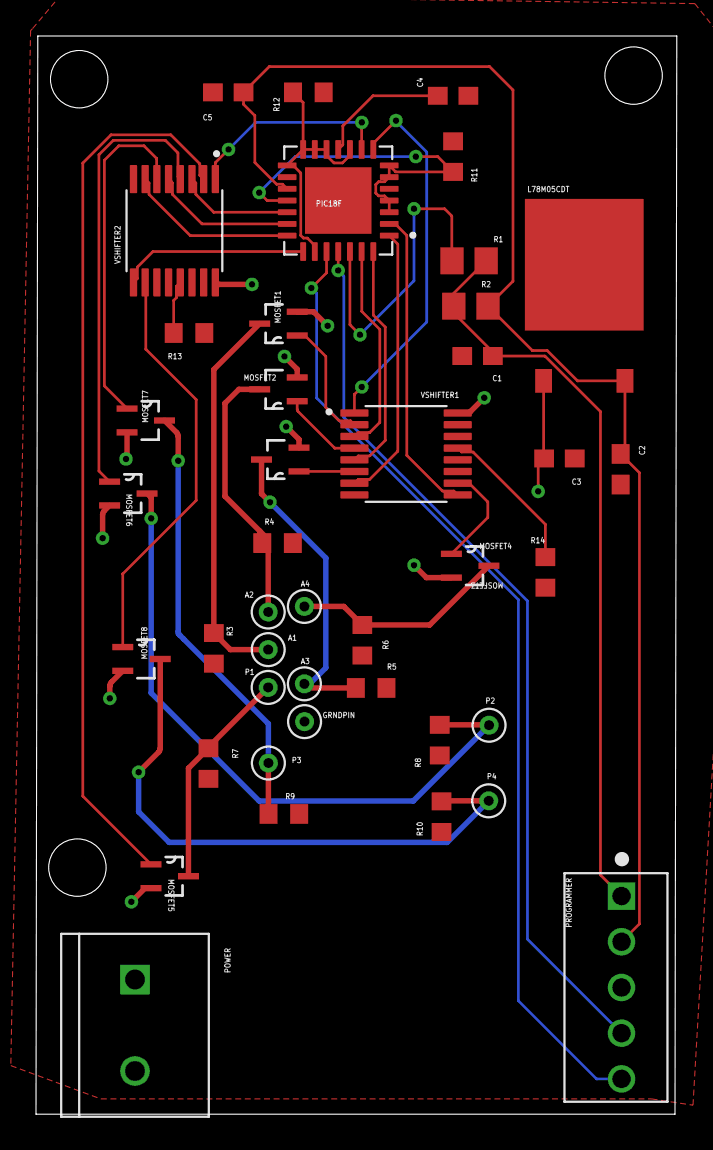
[picture p43: board schematic.brd from above]

Board: 2 copper layers, 35.6 x 59.9 mm, 42 parts (0 on the bottom side), 38 nets.
