siddij3/Inkjet-Printer/(commit log)

2018-04-14 Prototyping
    CAD models, schematics and PIC Code
    [Bearing O.ipt, Bearing O.stl, Carriage Assembly.SLDASM, Carriage Assembly.iam, HP45 Printhead Cap.ipt, HP45 Printhead Cap.stl, HP45 Printhead Holder.ipt, HP45 Printhead Holder.stl]
2018-04-17 PCB
    Completed board 1.0
    [PIC18F25K50.X.production.obj, schematic.brd, schematic.sch]
2018-04-18 GRB File
    GRB File made and some changes to PCB (Spring loaded pins, names)
    [schematic.sch]
2018-04-19 PIC
    Source Files automated changes
    [PIC18F25K50.X.production.obj]
2018-04-19 Motor Carrier
    Made the Y motor carrier
    [Bearing O.0002.ipt, Bearing O.ipt, Bearing O.stl, Y- motor carrier.0027.ipt, Y- motor carrier.ipt, Y- motor carrier.stl]
2018-04-22 PCB Changes
    Revised pinheads, modified libraries
    [PCB-BOM.xlsx, schematic.brd, schematic.dxf, schematic.sch]
2018-04-22 PCB
    Done
    [schematic.brd, schematic.sch]
2018-04-22 Done NOw?
    [schematic.brd, schematic.sch]
2018-04-22 backup files
    [Printhead.0001.iam, Printhead.iam]
2018-04-23 Minor FIx
    PCB - added Select pin from Shifter to Low Logic with 10Ω Resistor intermeditate
    [schematic.brd, schematic.sch]
2018-04-23 Smaller Fixes
    Follow up for adding resistors
    [PCB-BOM.xlsx, schematic.brd]
2018-04-23 PIC Codde
    Code that works for an N-channel MOSFET
    1 = on
    0 = off
    [PIC18F25K50.X.production.obj]
2018-04-23 PMOS
    Code Complete for Breadboard
    [PIC18F25K50.X.production.obj]
2018-04-26 Update
    April 26, 2018
    [Parts & Cost.xlsx, Y Belt Holder 2.0.stl, Y Belt Holder.ipt]
2018-05-01 Code
    All the primitives that are on an address that need to be triggered open next. Fixed
    [picmain.c]
